fabiobaltieri/traffic-light/hardware/traffic-light.kicad_pcb

## KiCad design hardware/traffic-light.kicad_pcb (2025-08-24)

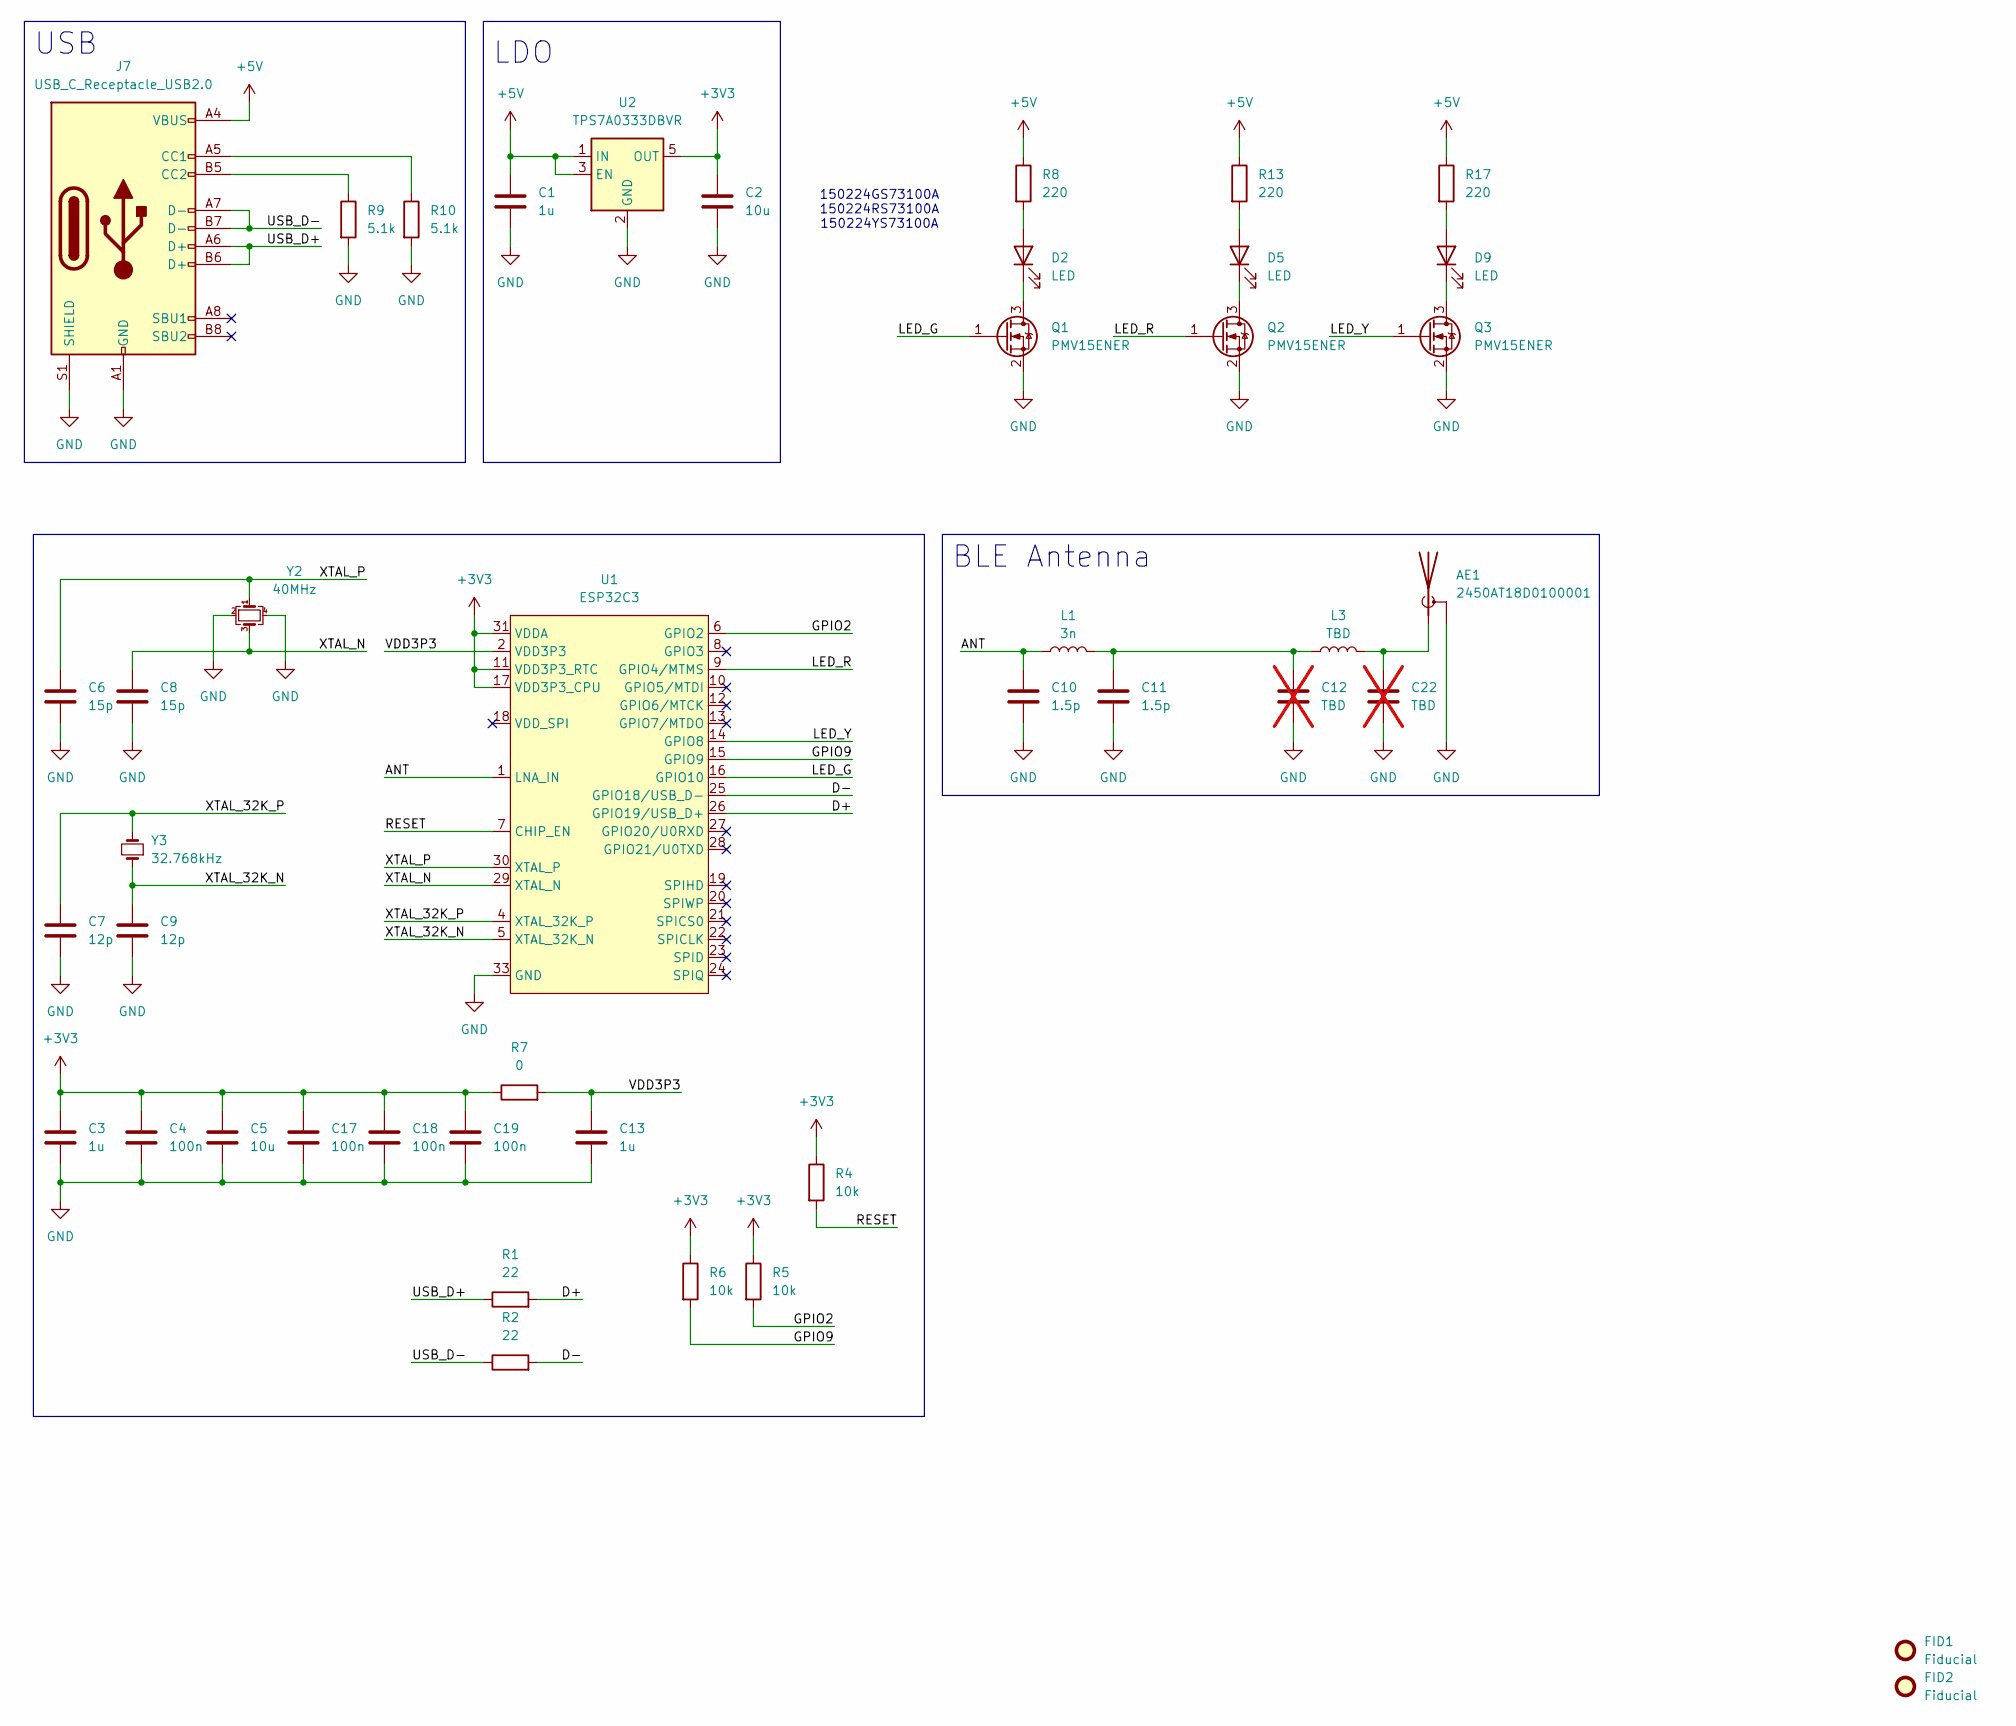
[picture p1: schematic traffic-light.kicad_sch]

Parts:
AE1: 2450AT18D0100001; 2450AT18D0100001-R
C1, C3, C13: 1u; C_0402_Worthington
C2, C5: 10u; C_0402_Worthington
C4, C17, C18, C19: 100n; C_0402_Worthington
C6, C8: 15p; C_0402_Worthington
C7, C9: 12p; C_0402_Worthington
C10, C11: 1.5p; C_0402_Worthington
C12, C22: TBD; C_0402_Worthington; not fitted
D2, D5, D9: LED; Wurth_LED_2214
FID1, FID2: Fiducial; Fiducial_0.75mm_Mask1.5mm
J7: USB_C_Receptacle_USB2.0; USB_C_Receptacle_JAE_DX07S016JA1R1500
L1: 3n; L_0402_Worthington
L3: TBD; L_0402_Worthington
Q1, Q2, Q3: PMV15ENER; SOT-23
R1, R2: 22; R_0603_1608Metric
R4, R5, R6: 10k; R_0402_Worthington
R7: 0; R_0402_Worthington
R8, R13, R17: 220; R_0402_Worthington
R9, R10: 5.1k; R_0402_Worthington
U1: ESP32C3; QFN-32-1EP_5x5mm_P0.5mm_EP3.7x3.7mm
U2: TPS7A0333DBVR; SOT-23-5
Y2: 40MHz; Crystal_SMD_2016-4Pin_2.0x1.6mm
Y3: 32.768kHz; Crystal_SMD_2012-2Pin_2.0x1.2mm

Connections:
+3V3: C2.1, C3.1, C4.1, C5.1, C17.1, C18.1, C19.1, R4.1, R5.1, R6.1, R7.1, U1.11 (VDD3P3_RTC), U1.17 (VDD3P3_CPU), U1.31 (VDDA), U1.32 (VDDA), U2.5 (OUT)
+5V: C1.1, J7.A4 (VBUS), J7.A9 (VBUS), J7.B4 (VBUS), J7.B9 (VBUS), R8.1, R13.1, R17.1, U2.1 (IN), U2.3 (EN)
/ANT: C10.1, L1.1, U1.1 (LNA_IN)
/D+: R1.2, U1.26 (GPIO19/USB_D+)
/D-: R2.2, U1.25 (GPIO18/USB_D-)
/GPIO2: R5.2, U1.6 (GPIO2)
/GPIO9: R6.2, U1.15 (GPIO9)
/LED_G: Q1.1 (G), U1.16 (GPIO10)
/LED_R: Q2.1 (G), U1.9 (GPIO4/MTMS)
/LED_Y: Q3.1 (G), U1.14 (GPIO8)
/RESET: R4.2, U1.7 (CHIP_EN)
/USB_D+: J7.A6 (D+), J7.B6 (D+), R1.1
/USB_D-: J7.A7 (D-), J7.B7 (D-), R2.1
/XTAL_32K_N: C9.1, U1.5 (XTAL_32K_N), Y3.1
/XTAL_32K_P: C7.1, U1.4 (XTAL_32K_P), Y3.2
/XTAL_N: C8.1, U1.29 (XTAL_N), Y2.3
/XTAL_P: C6.1, U1.30 (XTAL_P), Y2.1
GND: AE1.2 (Shield), C1.2, C2.2, C3.2, C4.2, C5.2, C6.2, C7.2, C8.2, C9.2, C10.2, C11.2, C12.2, C13.2, C17.2, C18.2, C19.2, C22.2, J7.A1 (GND), J7.A12 (GND), J7.B1 (GND), J7.B12 (GND), J7.S1 (SHIELD), Q1.2 (S), Q2.2 (S), Q3.2 (S), R9.2, R10.2, U1.33 (GND), U2.2 (GND), Y2.2, Y2.4
unnamed: AE1.1 (A), C22.1, L3.1
unnamed: C11.1, C12.1, L1.2, L3.2
unnamed: D2.2 (A), R8.2
unnamed: D2.1 (K), Q1.3 (D)
unnamed: D5.2 (A), R13.2
unnamed: D5.1 (K), Q2.3 (D)
unnamed: D9.2 (A), R17.2
unnamed: D9.1 (K), Q3.3 (D)
unnamed: J7.A5 (CC1), R10.1
unnamed: J7.B5 (CC2), R9.1
VDD3P3: C13.1, R7.2, U1.2 (VDD3P3), U1.3 (VDD3P3)

Notes on the sheet:
USB
150224GS73100A 150224RS73100A 150224YS73100A
BLE Antenna
LDO

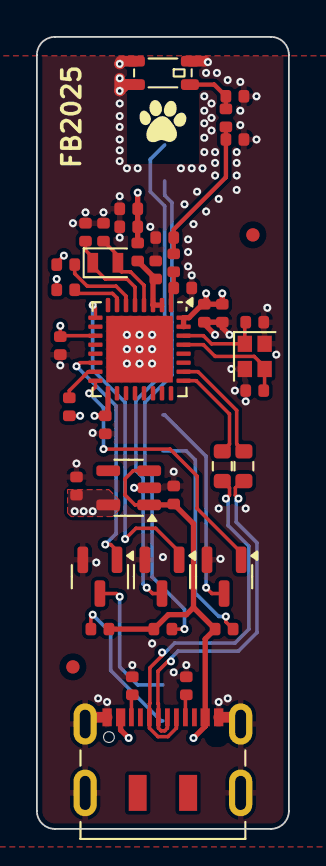
[picture p2: board traffic-light.kicad_pcb from above]

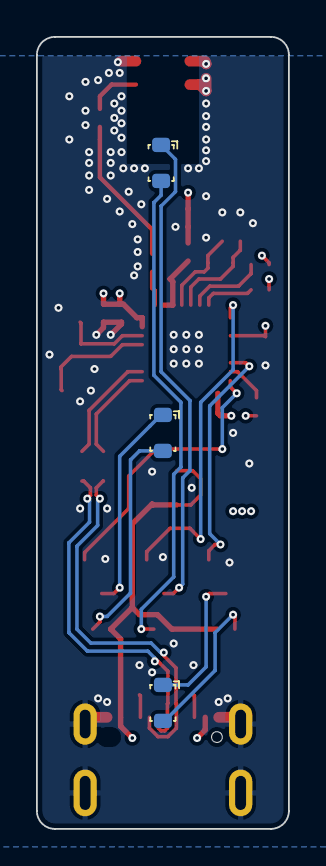
[picture p3: board traffic-light.kicad_pcb from below]

Board: 4 copper layers, 14.0 x 44.0 mm, 44 parts (3 on the bottom side), 29 nets.
