fabiobaltieri/traffic-light/(commit log)

2025-08-24 initial import
    [traffic-light.kicad_pcb, traffic-light.kicad_sch]
2025-09-02 fw: fix a horrible typo
    [data_fetcher.c, data_parser.c, leds.c, main.c]
2026-01-07 fw: set board full_name
2026-09-21 firmware: boards: update to match upstream changes
